yellobyte/YB-ESP32-S3-DAC/README.md

## YB-ESP32-S3-DAC Development Board Overview:
The **YB-ESP32-S3-DAC** is an audio development board based on Espressif's ESP32-S3 MCU with **Stereo Headphone** and **Stereo Speaker** output. It features an **ESP32-S3-WROOM-1** module (16MB Flash/8MB PSRAM or 8MB Flash/2MB PSRAM, WiFi PCB antenna) and is available on sales platforms [eBay](https://www.ebay.de/sch/i.html?_nkw=yb-esp32-s3) and [Ricardo.ch](https://www.ricardo.ch/en/s/YB-ESP32-S3). 

The 4-layer board is packed with features. It provides a **Texas Instruments TLV320 Stereo Audio DAC** with audio processing capability and integrated **Stereo Class-D Speaker Amplifier**, **3.5mm stereo audio jack**, **microSD** card slot, **CH334 USB-Hub** chip, **CH343 USB-UART bridge** chip, **USB-C connector** for software upload, serial output, JTAG debugging and/or feeding power to the board, **two status LEDs** and lots of **GPIO pins** for free use.

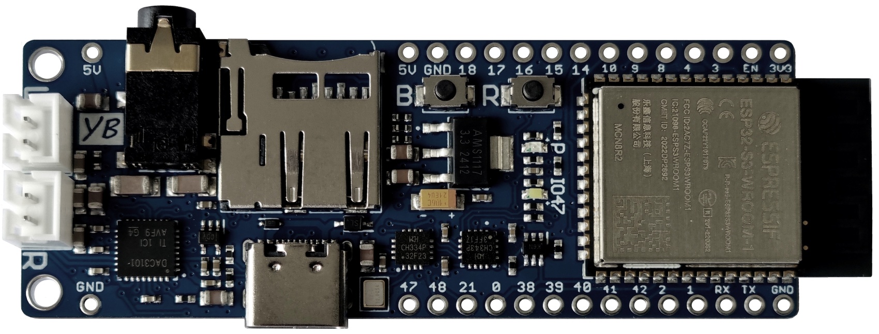
[picture p1: doc/YB-ESP32-S3-DAC_top.jpg]


Since the TLV320DAC3101 chip features sophisticated **audio processing capabilities** you can implement various types of audio filters, enable dynamic range compression (DRC), generate a 3D effect or use the integrated beep generator. The Arduino library [TLV320DAC3101](https://github.com/yellobyte/TLV320DAC3101) provides everything needed and lots of examples.

Due to the many available GPIOs you can connect additional hardware to the board, e.g. TFT displays, rotary encoders, IR receivers, modules that communicates via I2C/SPI and much more. The **I2S bus signals** (**D**ata, **L**eft/**R**ight (word) clock, **B**it clock) are accessible via **solder pads** on the bottom of the board for attaching external I2S components if needed.

The onboard USB-Hub (USB high-speed HUB controller chip CH334) allows for simultaneous **JTAG debugging** and **serial output**. More info further down.

The board is highly [**breadboard compatible**](https://github.com/yellobyte/YB-ESP32-S3-DAC/raw/main/doc/YB-ESP32-S3-DAC_on_breadboard.jpg) for it leaves one row of accessible breadboard contacts on either side of the board. All I/O ports (GPIOx) are clearly labeled on both sides of the board.

## Quickstart guide:
**All YB-ESP32-S3-DAC boards delivered have already been flashed with software example 'Play-All-MP3-Files-on-SD'.**

- Step 1) connect one or two 8Ω loudspeaker(s) or a headphone to the board
- Step 2) insert a microSD card (FAT32) holding some *.mp3 files
- Step 3) apply power (via USB or 5V pins)

That's it. The status LED will light up when the microSD card has been detected ok and the board will start playing all *.mp3 files found.

Carrying on you could build and upload one of the many provided ArduinoIDE/PlatformIO [examples](https://github.com/yellobyte/YB-ESP32-S3-DAC/tree/main/examples) and listen to **internet radio stations**, try out the **3D sound effect**, apply **low/high pass audio filters** and much more.

## YB-ESP32-S3-DAC board features in detail:
- **ESP32-S3-WROOM-1** module with 16MB Flash/2MB PSRAM (-N16R8) or 8MB Flash/2MB PSRAM (-N8R2), WiFi PCB antenna
- **TLV320DAC3101 Stereo Audio DAC** with audio processing capability (audio filters of 1st and 2nd order, dynamic range compression DRC, 3D effect), Stereo Class-D Speaker Amplifier (2 x 1.3W@8Ω) and Stereo Headphone output (2 x 65mW@16Ω impedance min.). The DAC is connected to the ESP32-S3 as follows:
  - Via I2C for DAC configuration & programming (I2C address 0x18):
    - *GPIO8 - SDA* (data line)
    - *GPIO9 - SCL* (clock line)
  - Via I2S for transferring audio data from ESP32-S3 to DAC:
    - *GPIO4 - MCLK* (master clock, optional when solder bridge is closed)
    - *GPIO5 - BCLK* (bit clock)
    - *GPIO6 - LRCLK/WCLK* (frame/word clock)
    - *GPIO7 - DIN* (digital audio signal)

  Note: GPIOs 5/6/7 are not wired to a board pin, however they are available via labeled solder pins on the bottom of the board.
 - **JST PH2.0 connectors** for easy connecting 2 loudspeakers (8Ω impedance, left & right audio channels)
 - **3.5mm stereo audio jack** acting as stereo headphone/headset output (16Ω min., microphone input, button press detection) or stereo line output (10kΩ nom.).
 - **microSD** card slot connected to the ESP32-S3 via fast SPI bus *FSPI*:
   - *GPIO10 - SCS* (SPI bus control, chip select, this control line is not needed for SD_MMC-lib and available for other usage when solder bridge *SD_CS* is open [default closed])
   - *GPIO11 - MOSI* (SPI bus data communication, SD_MMC calls it *CMD*)
   - *GPIO12 - SCK* (SPI bus clock signal)
   - *GPIO13 - MISO* (SPI bus data communication, SD_MMC calls it *D0*)

   Note: GPIOs 11/12/13 are not wired to any board pin, they are exclusively used for the microSD slot.
 - **control LEDs**. One LED labeled 'P' is connected to the 3.3V rail to indicate board power and the other LED labeled 'IO47' is connected to GPIO47 which can be used as status LED.
 - **USB-C** port connected to the onboard CH334 USB-Hub chip. This allows for serial output and simultaneous JTAG debugging as well as software upload (e.g. via ArduinoIDE, VSCode/PlatformIO etc). The ESP32-S3 contains an inbuild JTAG adapter hence [**debugging**](https://github.com/yellobyte/ESP32-DevBoards-Getting-Started/tree/main/debugging) becomes fairly easy.
 - **hardware logic** for *automatic* software upload (supported by most Development IDEs) via USB-C port using the onboard CH343 USB-UART bridge chip. How this works is explained [here](https://github.com/yellobyte/ESP32-DevBoards-Getting-Started/tree/main/reset_and_software_upload).
 - **pushbuttons**. One is labeled 'R' and resets the ESP32-S3 (shorts EN pin to ground) and the other one is labeled 'B' and shorts GPIO0 to ground when pressed. The combination is used to force the board into boot mode.
 - **lots of available GPIOs** for connecting LEDs, buttons, additional modules via second SPI bus or I2C, e.g displays, rotary encoders, bluetooth, etc.

## Board Pin Layout:
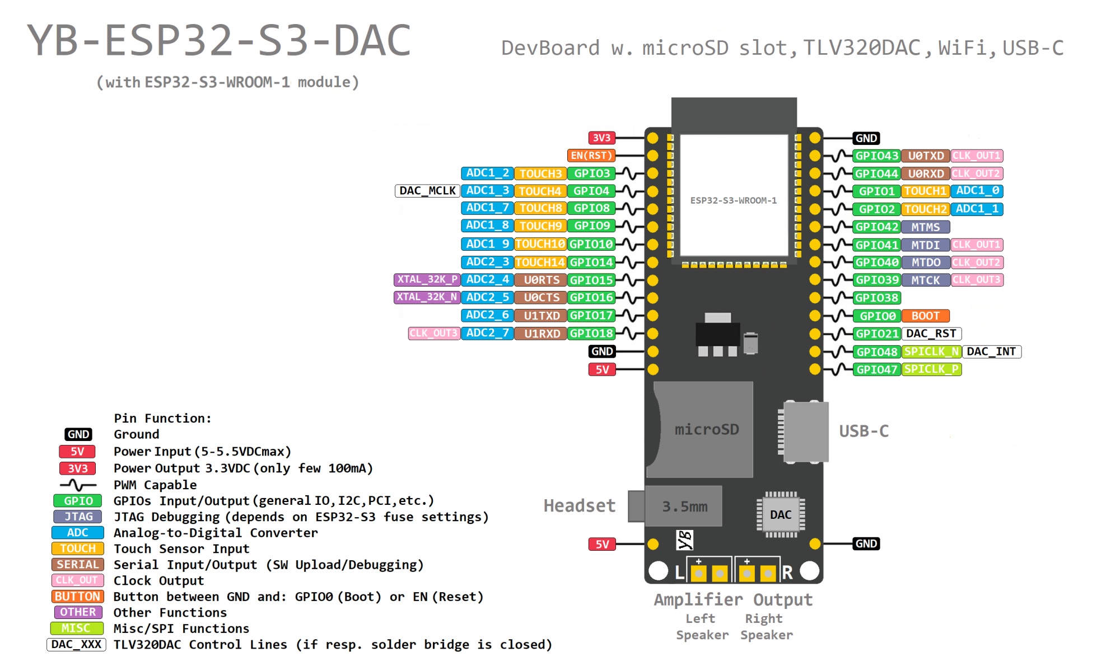
[picture p2: doc/YB-ESP32-S3-DAC_pinlayout.jpg]
 

The boards **outline** and **schematic** files are all located in folder [doc](https://github.com/yellobyte/YB-ESP32-S3-DAC/raw/main/doc), together with data sheets for Espressif's MCU ESP32-S3 and the ESP32-S3-WROOM-1 module family.

## Powering the board:
There are two ways to provide power to the board:
  - through the USB-C port or
  - ~5VDC applied to the 5V pin

The board uses LDOs to drop the external supply voltage down to 3.3V/1.8V needed by the board circuitry. The TLV320 speaker drivers get their voltage directly from pin '5V'. They can operate up to 5.5V and their absolute maximum rating is 6V. Therefore **never supply more than ~5.5VDC to the '5V' power input pins** !

Normal operating current of the idle board (all GPIOs unconnected, no audio output, WiFi disabled) is about 45mA. With WiFi active the board draws about 100mA (mainly depending on WiFi link). With WiFi active, a microSD in the slot and lower audio output power on both amp channels the current rises to ~160mA.

### Recommended wiring for max. audio output power:
Each speaker channel produces max. 1.3W output power at 8Ω. If your project requires more then just a few ~100mW of audio output power it is recommended to use a capable power supply (5VDC/1A). An additional capacitor of ~100uF or greater value across the 5V/GND pins of the board wouldn't hurt either.

## Application hints:
The board uses a WCH chip CH343P (USB-UART bridge). If you haven't done yet then you need to install the CH343 Driver on your Laptop/PC. For Windows go [here](https://www.wch-ic.com/search?t=all&q=ch343) and download and install the newest version of the driver. Linux provides CH34x drivers by default.

### Arduino IDE:
As of Arduino ESP32 Core V3.3.6 you open the board list, enter "yb" and select "**Yellobyte YB-ESP32-S3-DAC**". Then choose the proper settings for COM port, debug level, etc. as shown below. Be aware, since the ESP32-S3 MCU is very versatile there are a lot of build options to play with. Espressif's homepage offers some help.

Correct **settings** for boards with 16MB Flash & 8MB PSRAM (**-N16R8**):
- Board: *YB-ESP32-S3-DAC*
- USB CDC On Boot: _Disabled_
- Flash Size: *16MB (128Mb)*
- Partition Scheme: e.g. *16MB with spiffs (...)*, *8MB with spiffs (...)*, *Default 4MB with spiffs (...)*, etc.
- PSRAM: *OPI PSRAM*

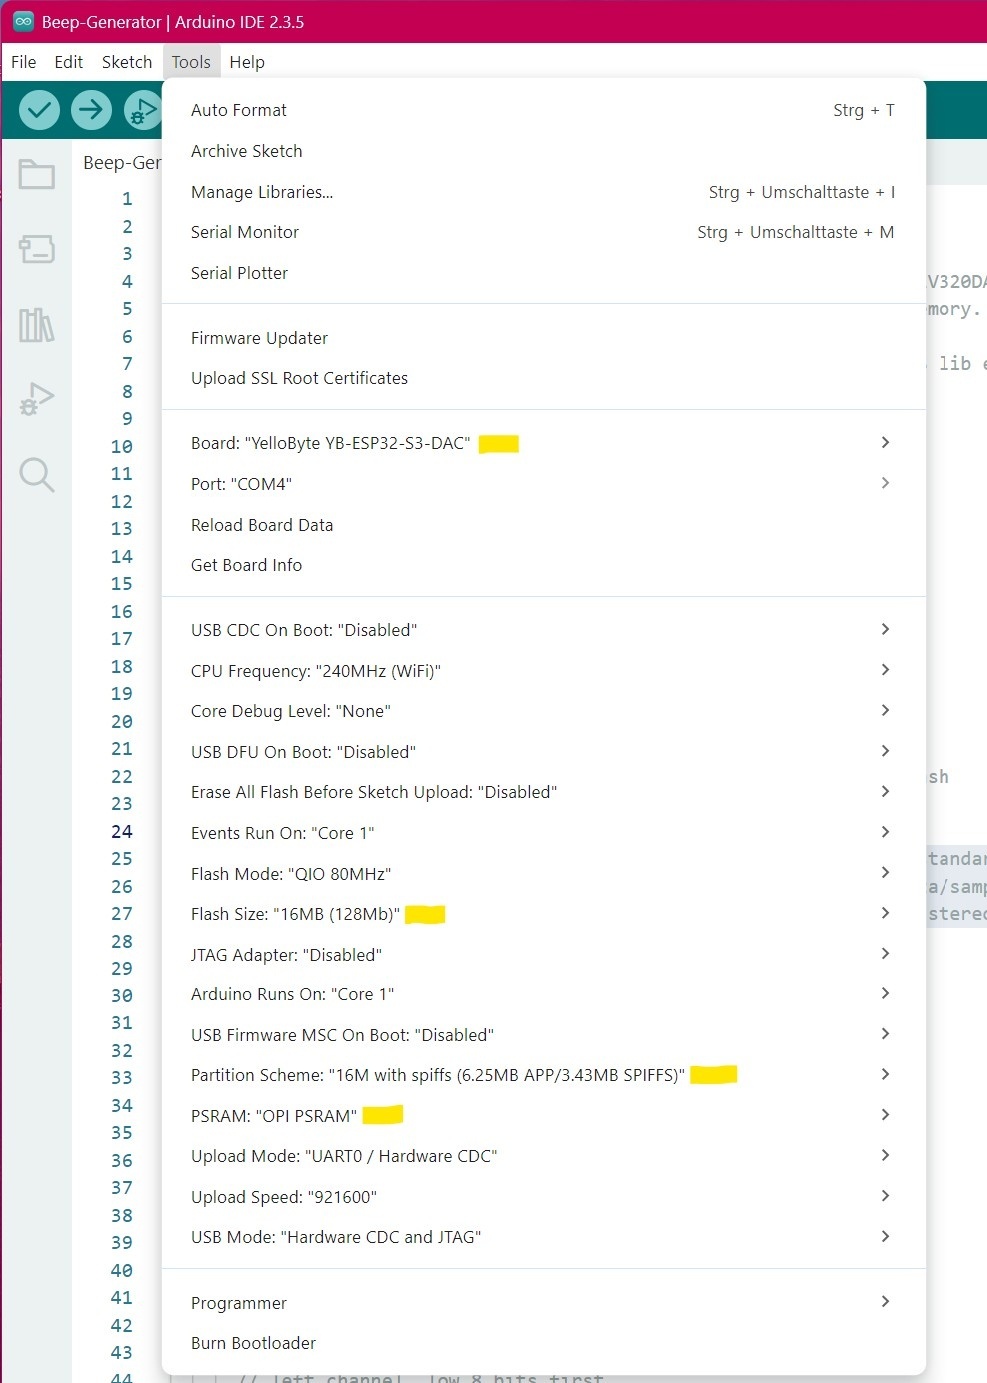
[picture p3: doc/YB-ESP32-S3-DAC_ArduinoIDE-Settings-N16R8.jpg]
 

Correct **settings** for boards with 8MB Flash & 2MB PSRAM (**-N8R2**):
- Board: *YB-ESP32-S3-DAC*
- USB CDC On Boot: _Disabled_
- Flash Size: *8MB (64Mb)*
- Partition Scheme: e.g. *8MB with spiffs (...)*, *Default 4MB with spiffs (...)*, etc.
- PSRAM: *QSPI PSRAM*

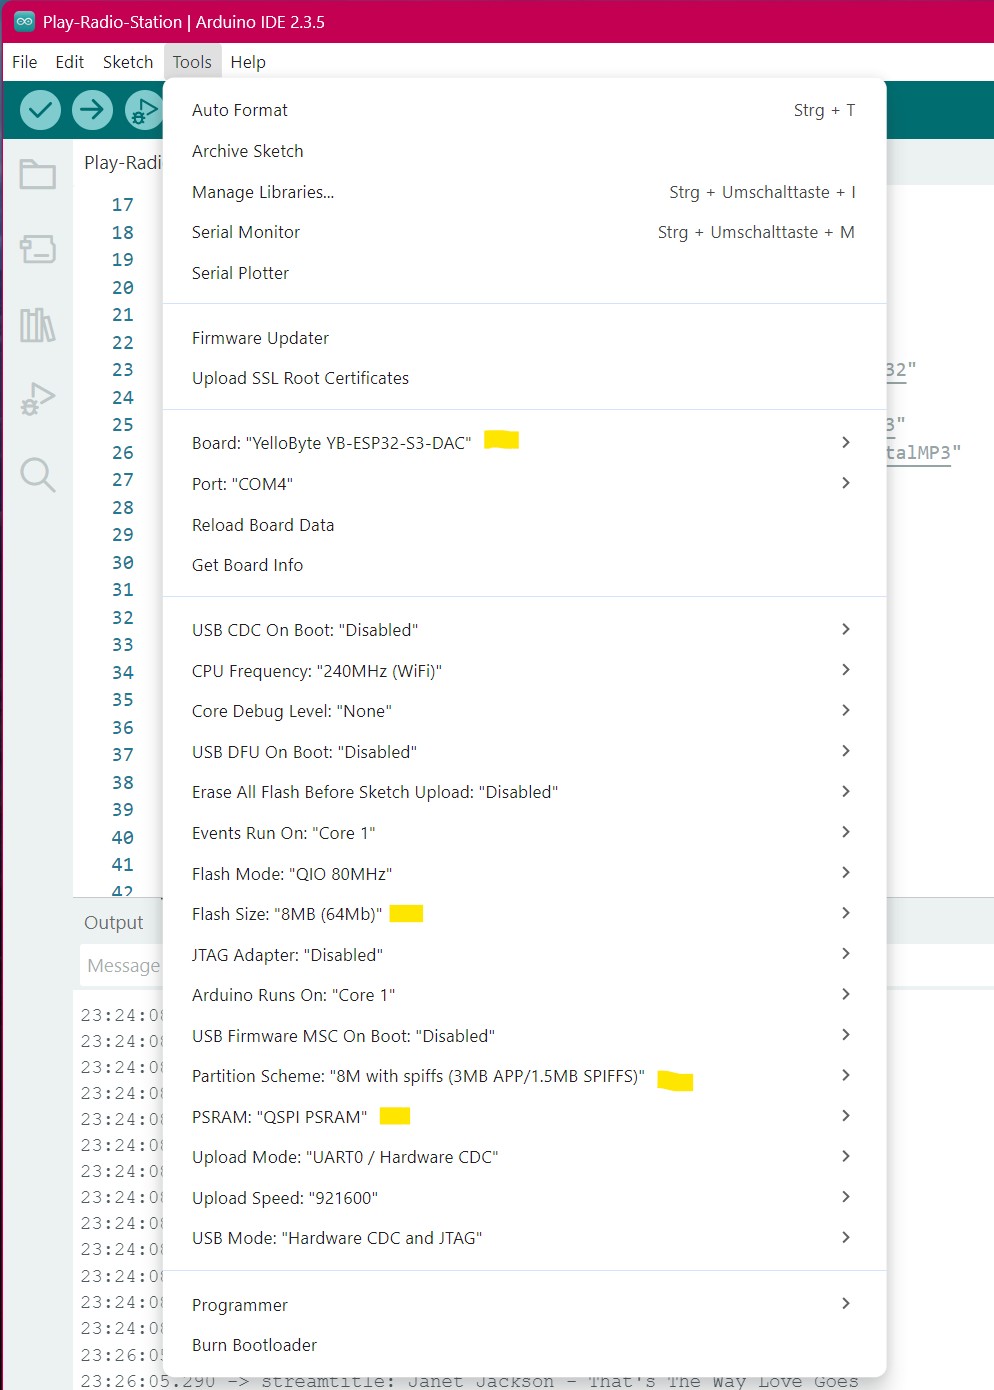
[picture p4: doc/YB-ESP32-S3-DAC_ArduinoIDE-Settings-N8R2.jpg]
 

### PlatformIO:
Building with **PlatformIO** is easy as well. Starting with Arduino ESP32 Core v3.3.6 the VSCode/PlatformIO IDE holds the necessary *.json board file which provides default board definitions & settings.

Just create a new project and give it a name, then go to board selection, enter "yb-" and choose your YB-ESP32-S3-*** board from the list that is popping up.

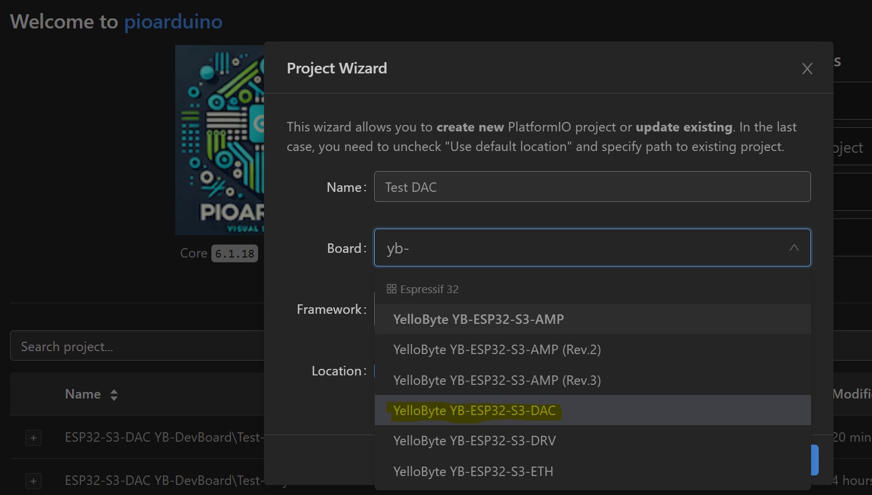
[picture p5: doc/YB-ESP32-S3-DAC_PlatformIO_board_selection.jpg]
 

**Important:**  
1.) If the WROOM module features **16MB** flash memory, add the following lines to the *platformio.ini* project file's respective **[env]** section to account for the 16MB flash available. Otherwise you are restricted to 8MB (as set in the *.json board file).  
```
...
board_build.partitions = default_16MB.csv
board_upload.flash_size = 16MB
board_upload.maximum_size = 16777216
...
```
2.) If the WROOM module features **>= 8MB** PSRAM then it needs below line to prevent the core from crashing:
```
...
board_build.arduino.memory_type = qio_opi
...
```

### Using the USB-C port:
With the board connected to your PC/Laptop you'll see 3 additional USB devices. Two COM ports: **Serial USB device** and **USB-Enhanced-Serial CH343** and one device: **USB JTAG/serial debug unit** (or similar, depending on your OS).

You can connect a serial monitor program on your PC/Laptop to device "USB-Enhanced-Serial CH343" and watch the serial output generated with e.g. Serial.print(). Important: This serial connection is **not** affected by any board reset.

Device "USB JTAG/serial debug unit" lets you simultaneously debug the board via the ESP32-S3 integrated JTAG debug circuitry. How to use the latter for debugging is explained in detail [**here**](https://github.com/yellobyte/ESP32-DevBoards-Getting-Started/tree/main/debugging).

**Please note:** The PlatformIO builder scripts (*.json) for modules containing ESP32-S3/C3 normally define the build flag _ARDUINO_USB_MODE=1_. This enables the USB-Serial-JTAG controller and disables the USB-OTG-Controller in the ESP32-S3. If you want to override it you can (re-)define it in your platformio.ini control file. Normally you don't have to worry about it.

### Software Upload to the board:
Uploading new software to boards with your IDE is a breeze. Select the correct COM port and upload the program. The [integrated hardware logic](https://github.com/yellobyte/ESP32-DevBoards-Getting-Started/tree/main/reset_and_software_upload) will put the board into upload mode automatically.

However, at any time and if needed you can force the ESP32-S3 into upload mode *manually*. Keep the **'B'** button pressed, then press/release the **'R'** button and finally release the **'B'** button. The serial monitor output will subsequently confirm the boards readiness for getting flashed.

```
....
23:19:07.453 > ESP-ROM:esp32s3-20210327
23:19:07.453 > Build:Mar 27 2021
23:19:07.453 > rst:0x1 (POWERON),boot:0x0 (DOWNLOAD(USB/UART0))
23:19:07.459 > waiting for download
```

### Flash/RAM usage:
The -N8R2 module on the board provides enough memory even for demanding projects. Building e.g. software example [Play-All-MP3-Files-on-SD](https://github.com/yellobyte/YB-ESP32-S3-DAC/tree/main/examples/ArduinoIDE/Play-All-MP3-Files-on-SD) shows the following Flash/RAM usage:
```
Executing task: C:\Users\tj\.platformio\penv\Scripts\platformio.exe run

Processing release (platform: https://github.com/pioarduino/platform-espressif32/releases/download/stable/platform-espressif32.zip; framework: arduino; board: yb_esp32s3_dac)
------------------------------------------------------------------------------------------------------------------------
Verbose mode can be enabled via `-v, --verbose` option
CONFIGURATION: https://docs.platformio.org/page/boards/espressif32/yb_esp32s3_dac.html
PLATFORM: Espressif 32 (55.3.37) > YelloByte YB-ESP32-S3-DAC
HARDWARE: ESP32S3 240MHz, 320KB RAM, 8MB Flash
DEBUG: Current (esp-builtin) On-board (esp-builtin) External (cmsis-dap, esp-bridge, esp-prog, iot-bus-jtag, jlink, minimodule, olimex-arm-usb-ocd, olimex-arm-usb-ocd-h, olimex-arm-usb-tiny-h, olimex-jtag-tiny, tumpa)
PACKAGES:
 - contrib-piohome @ 3.4.4
 - framework-arduinoespressif32 @ 3.3.7
 - framework-arduinoespressif32-libs @ 5.5.0+sha.87912cd291
 - tool-esp-rom-elfs @ 2024.10.11
 - tool-esptoolpy @ 5.1.2
 - toolchain-xtensa-esp-elf @ 14.2.0+20251107
*** Applied include path shortening for 336 framework paths ***
*** Path length reduced from 38684 to ~13910 characters ***
*** Estimated savings: 24192 characters ***
LDF: Library Dependency Finder -> https://bit.ly/configure-pio-ldf
LDF Modes: Finder ~ chain, Compatibility ~ soft
Found 47 compatible libraries
Scanning dependencies...
Dependency Graph
|-- SD @ 3.3.7
|-- Adafruit BusIO @ 1.17.4
|-- Adafruit TLV320 I2S @ 1.0.0
|-- TLV320DAC3101 @ 1.1.0
|-- ESP32-audioI2S @ 3.4.4
|-- FS @ 3.3.7
|-- SPI @ 3.3.7
Building in release mode
Retrieving maximum program size .pio\build\release\firmware.elf
Checking size .pio\build\release\firmware.elf
Advanced Memory Usage is available via "PlatformIO Home > Project Inspect"
RAM:   [==        ]  18.1% (used 59376 bytes from 327680 bytes)
Flash: [======    ]  58.7% (used 1963226 bytes from 3342336 bytes)
```

## Integrating this board into your own PCB design projects:
Its easy. Folder [doc](https://github.com/yellobyte/YB-ESP32-S3-DAC/tree/main/doc) provides the Eagle library file **_yb-esp32-S3-DAC.lbr_** containing the board. Most other PCB design software (e.g. KiCad) are able to import and use Eagle lib files.

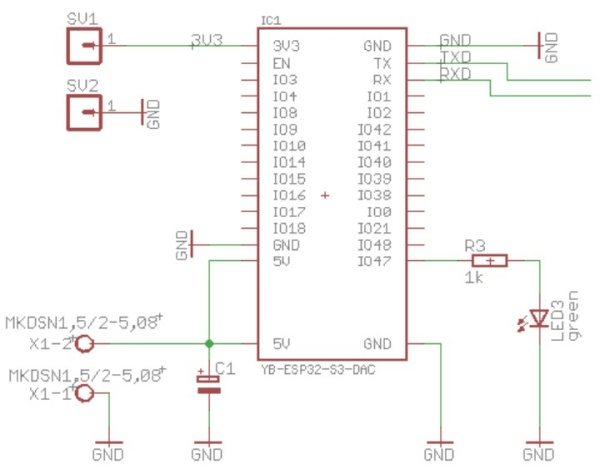
[picture p6: doc/Eagle_project_with_yb-esp32-s3-dac.jpg]
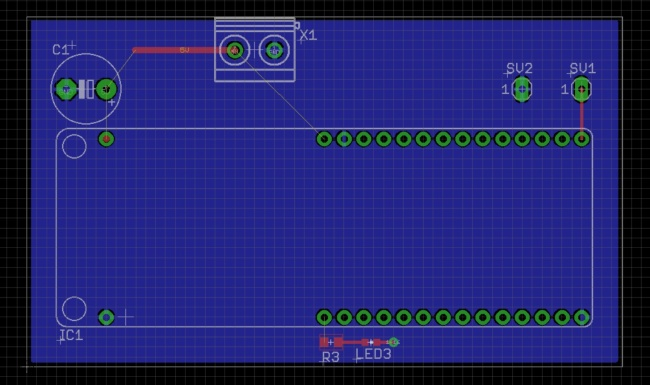
[picture p7: doc/Eagle_project_with_yb-esp32-s3-dac2.jpg]
<p align="center">&nbsp;</p>

## Running MicroPython on the board:

You can install MicroPython onto the YB-ESP32-S3-DAC board and use it's WiFi, SPI, I2C, ADC, GPIO and other features via python scripts.  
 
**Step 1)** Load MicroPython onto the board. Go to https://micropython.org/download/ESP32_GENERIC_S3/ and download the newest *.bin firmware release. Here you will find detailed installation instructions as well.

**Step 2)** Erase the entire flash on the board with 
```
esptool.py erase_flash
```
If esptool.py can't determine which port your board is connected to, try
```
esptool.py --port PORTNAME erase_flash
```
**Step 3)** Flash the previously downloaded firmware to the board, e.g.
```
esptool.py --port COM4 --baud 460800 write_flash 0 ESP32_GENERIC_S3-20260406-v1.28.0.bin
```
**Step 4)** Reboot the board by shortly pressing the 'R' button. Then connect your serial monitor to the correct port (here COM4) and press ENTER. If flashing was successful you will be greeted with
```
01:57:53.819 > Build:Mar 27 2021
01:57:53.819 > rst:0x1 (POWERON),boot:0x8 (SPI_FAST_FLASH_BOOT)
01:57:53.825 > SPIWP:0xee
01:57:53.825 > mode:DIO, clock div:1
01:57:53.825 > load:0x3fce2820,len:0xeac
01:57:53.830 > load:0x403c8700,len:0xc28
01:57:53.830 > load:0x403cb700,len:0x2ff8
01:57:53.830 > entry 0x403c88ac
01:57:54.370 > MicroPython v1.28.0 on 2026-04-06; Generic ESP32S3 module with ESP32S3
01:57:54.375 > Type "help()" for more information.
01:57:54.375 > >>> 
```
which confirms that MicroPython is now up and running on your board. Just enter *help()* and MicroPython will present some help info.

**Example: Switching the onboard status LED (GPIO47) on/off:**
```
>>> import machine <Enter>
>>> from machine import Pin <Enter>
>>> p0 = Pin(47, Pin.OUT) <Enter>
>>> p0.on() <Enter>
>>> p0.off() <Enter>
```

## General notes:
1) In case you get left channel output on the right speaker and vice-versa (L + R channels are swapped) you need to build with a [newer ESP32-AudioI2S library version](https://github.com/schreibfaul1/ESP32-audioI2S/releases) with this error fixed.

2) The ESP32-S3 includes four SPI controllers: SPI0, SPI1, SPI2(Fast SPI) and SPI3. SPI0/1 are reserved for Flash and PSRAM (if available) and should be left alone!
The remaining two are available for the public. In the ESP32-S3's Arduino universe SPI2 & SPI3 are named FSPI & HSPI. FSPI by default is assigned to GPIOs 10-15 and routed via IO MUX. However, both can get pinned to any available GPIO pin if needed but FSPI will be slower if routed through GPIO Matrix

3) The ESP32-S3-WROOM-1 module family comprises several [**versions**](https://github.com/yellobyte/ESP32-DevBoards-Getting-Started/raw/main/ESP32_specs_and_manuals/ESP32-S3-WROOM-1(U)_Variants.jpg). The **-1** versions come with embedded PCB antenna, the **-1U** versions with IPEX antenna socket instead. The extension -Nx(Ry) defines the amount of integrated FLASH/PSRAM, e.g. -N4 (4MB Flash, no PSRAM), -N4R2 (4 MB Flash, 2MB PSRAM), -N8R2 (8 MB Flash, 2MB PSRAM) etc.

4) The board supports USB Serial JTAG debugging via ESP32-S3 integrated JTAG circuitry. Look [**here**](https://github.com/yellobyte/ESP32-DevBoards-Getting-Started/tree/main/debugging).
