yellobyte/YB-ESP32-S3-DAC/examples/PlatformIO/PlayFilesOnSD-SdFatFS/Lautstärkeregelung_Empfehlungen_TLV320-Serie.md

Die TLV320-Serie von Texas Instruments (z. B. TLV320DAC310x, TLV320AIC3104, AIC3204) bietet eine
hohe Flexibilität und ermöglicht sowohl eine digitale als auch eine analoge Lautstärkeregelung. Die Wahl hängt von den Anforderungen an die Audioqualität und den Schaltungsaufbau ab. 
Hier ist eine Gegenüberstellung basierend auf den Datenblättern der TI TLV320-Reihe:
1. Digitale Lautstärkeregelung (Im Chip)

    Funktionsweise: Die Lautstärke wird direkt in den Registern des DACs gesteuert, bevor das Signal in das analoge Signal umgewandelt wird (DSP/Register-gesteuert).
    Vorteile:
        Perfekte Kanalgleichheit: Da es sich um eine mathematische Berechnung handelt, sind linker und rechter Kanal zu 100 % identisch.
        Kein mechanischer Verschleiß: Kein Knistern durch Abnutzung.
        Einfache Implementierung: Kann über I2C/SPI gesteuert werden.
    Nachteile:
        Reduzierung der effektiven Bit-Auflösung bei sehr niedrigen Lautstärken.
        Hinweis: Bei modernen 24-Bit-DACs wie der TLV320-Serie ist dies in der Praxis kaum hörbar. 

2. Analoge Lautstärkeregelung (Nach dem DAC)

    Funktionsweise: Der DAC gibt das Signal mit voller Auflösung aus, und ein analoger Verstärker/Potentiometer (intern im TLV320 oder extern) regelt die Amplitude.
    Vorteile:
        Besseres Signal-Rausch-Verhältnis (SNR): Bei geringer Lautstärke wird auch das Grundrauschen des DACs mit abgesenkt.
        Volle Dynamik: Die volle Bittiefe bleibt erhalten.
    Nachteile:
        Potenzielle Kanalungleichheit bei mechanischen Potentiometern.
        Mehr Schaltungsaufwand (externe Komponenten). 

Was ist bei TLV320 zu empfehlen?
Die TLV320-Chips (insb. Codecs wie TLV320AIC3104/AIC3204) verfügen über eine integrierte analoge Lautstärkeregelung nach der Wandlung (im Ausgangsmischer/Kopfhörerverstärker). 

    Empfehlung: Nutzen Sie die integrierte analoge Regelung der TLV320-Ausgangsstufen. Sie bietet die Vorteile einer analogen Regelung (kein Rauschen), ohne die Nachteile externer mechanischer Teile.
    Für eine "Best-of-both-worlds"-Lösung: Nutzen Sie die digitale Regelung für grobe Einstellungen und die analoge (im Chip) für die Feinabstimmung. 

Zusammenfassung der Eigenschaften
Feature 	        Digitale Regelung (Register)	Analoge Regelung (Ausgangs-Amp)
Kanalgleichheit	    Perfekt	                        Gut (wenn im Chip)
SNR	                Verringert sich bei leise	    Besser bei leise
Auflösung	        Bits gehen verloren	            Bleibt hoch
Verfügbar in        TLV320	Ja (in den Registern)	Ja (integrierte analoge Stufe)
Die meisten modernen Anwendungen mit TLV320-Komponenten (z.B. über I2C gesteuert) nutzen die integrierte Lautstärkeregelung, da sie sehr flexibel und rauscharm ist
