yellobyte/YB-ESP32-S3-DAC/doc/YB-ESP32-S3-DAC_ArduinoIDE_Board-Selection.jpg

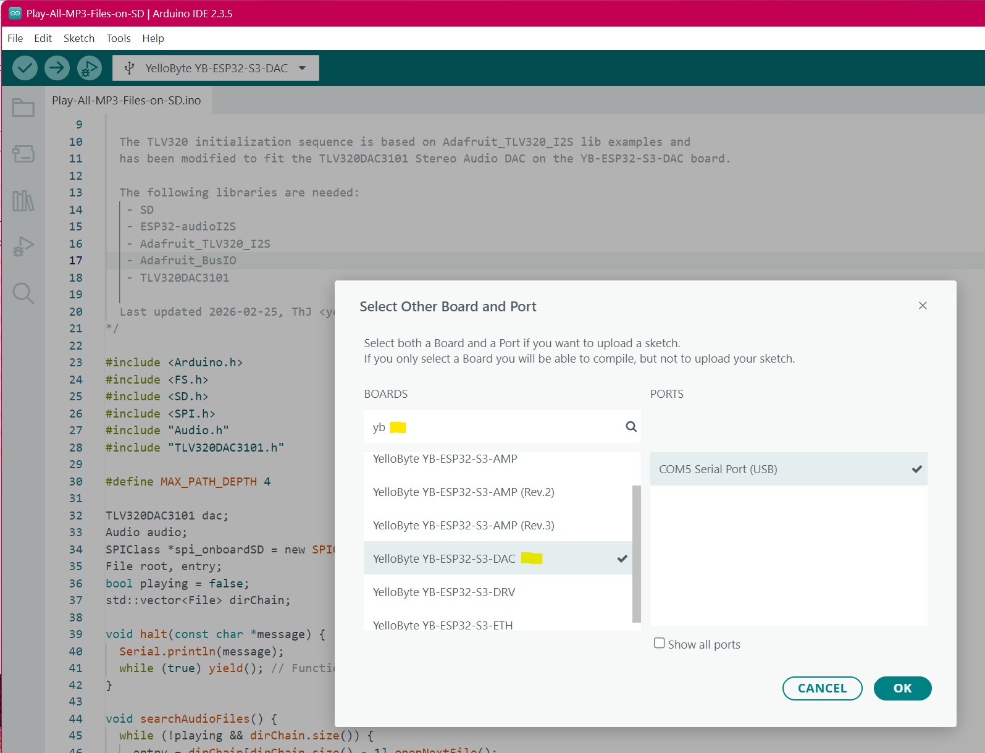
doc/YB-ESP32-S3-DAC_ArduinoIDE_Board-Selection.jpg
