yellobyte/YB-ESP32-S3-DAC/doc/YB-ESP32-S3-DAC_bottom.jpg

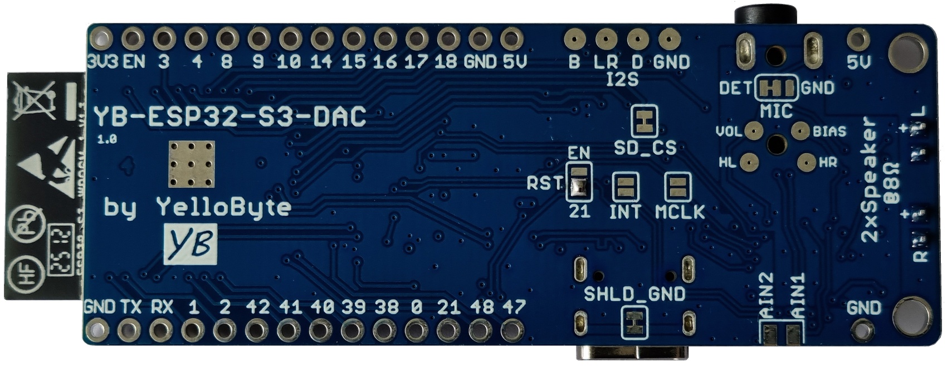
doc/YB-ESP32-S3-DAC_bottom.jpg
