yellobyte/YB-ESP32-S3-DAC/doc/YB-ESP32-S3-DAC_modules_replacement.jpg

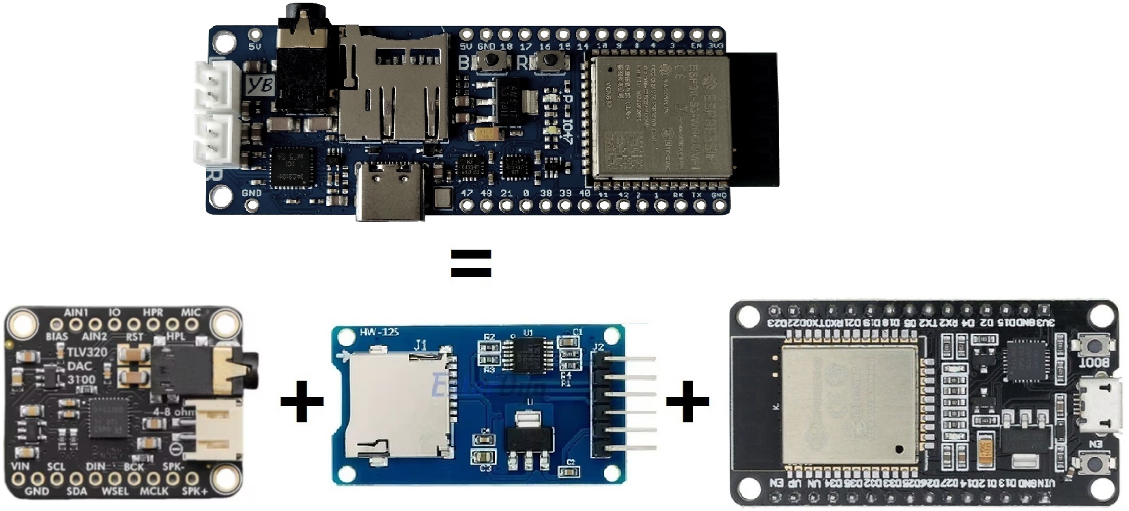
doc/YB-ESP32-S3-DAC_modules_replacement.jpg
