yellobyte/YB-ESP32-S3-DAC/doc/YB-ESP32-S3-DAC_on_breadboard.jpg

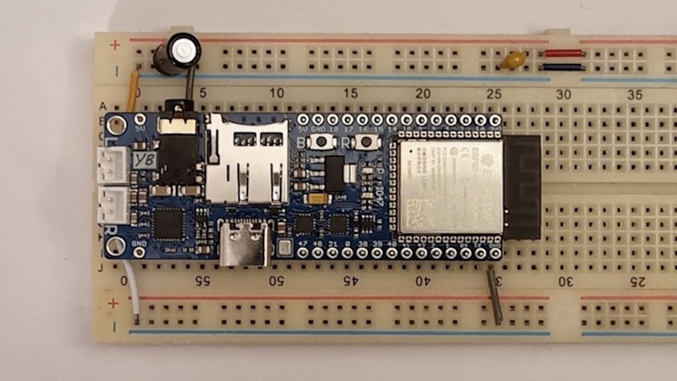
doc/YB-ESP32-S3-DAC_on_breadboard.jpg
