yellobyte/YB-ESP32-S3-DAC/doc/YB-ESP32-S3-DAC_outline.jpg

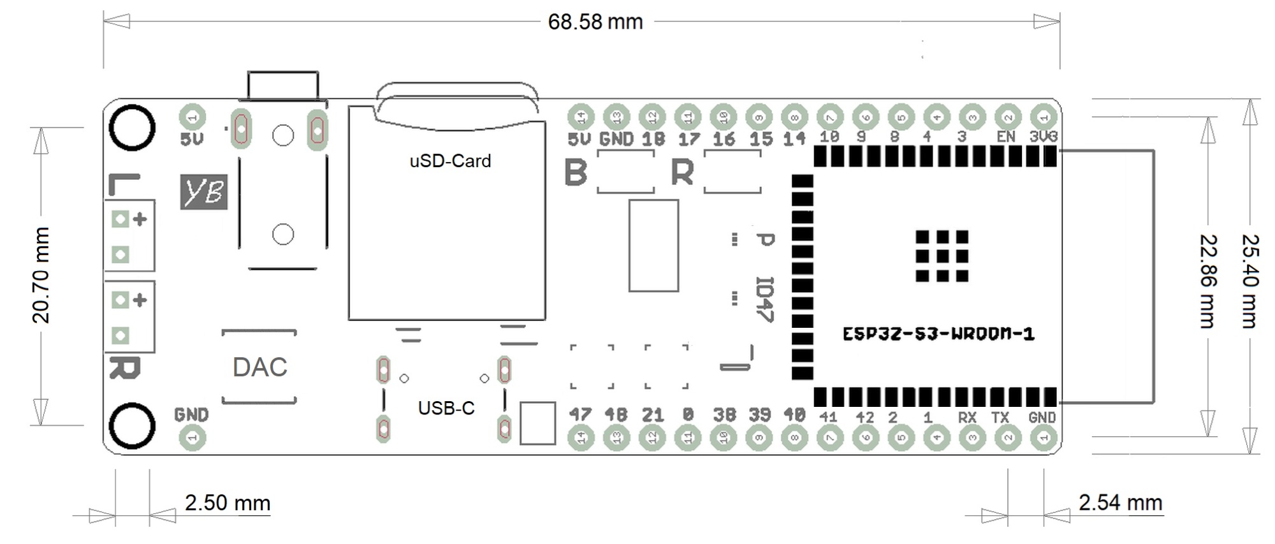
doc/YB-ESP32-S3-DAC_outline.jpg
