yellobyte/YB-ESP32-S3-DAC/doc/YB-ESP32-S3-DAC_schematic_2-2.jpg

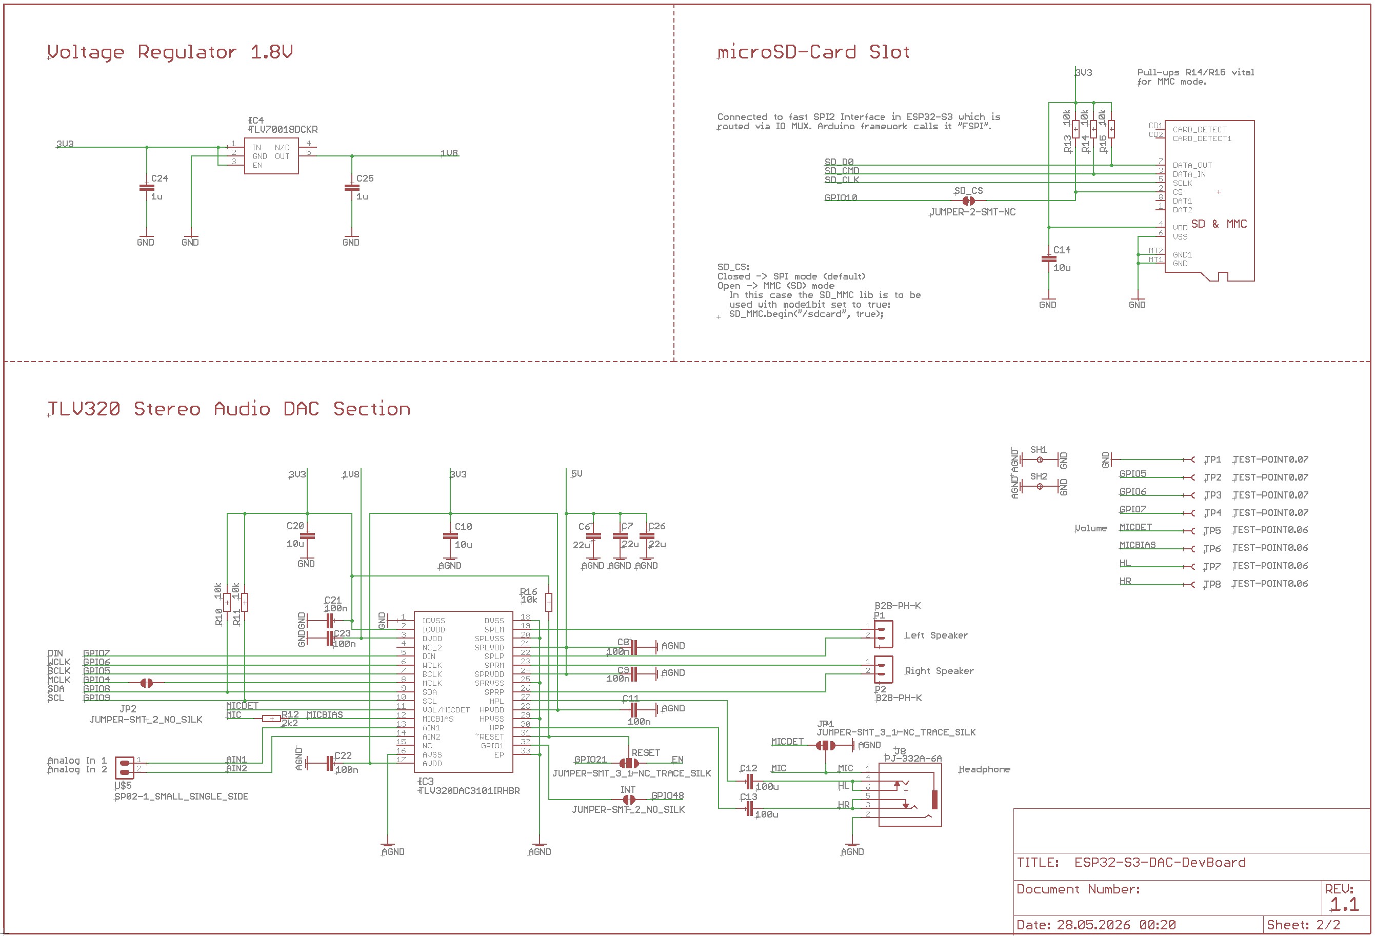
doc/YB-ESP32-S3-DAC_schematic_2-2.jpg
