yellobyte/YB-ESP32-S3-DAC/doc/YB-ESP32-S3-DAC_recommended_wiring.jpg

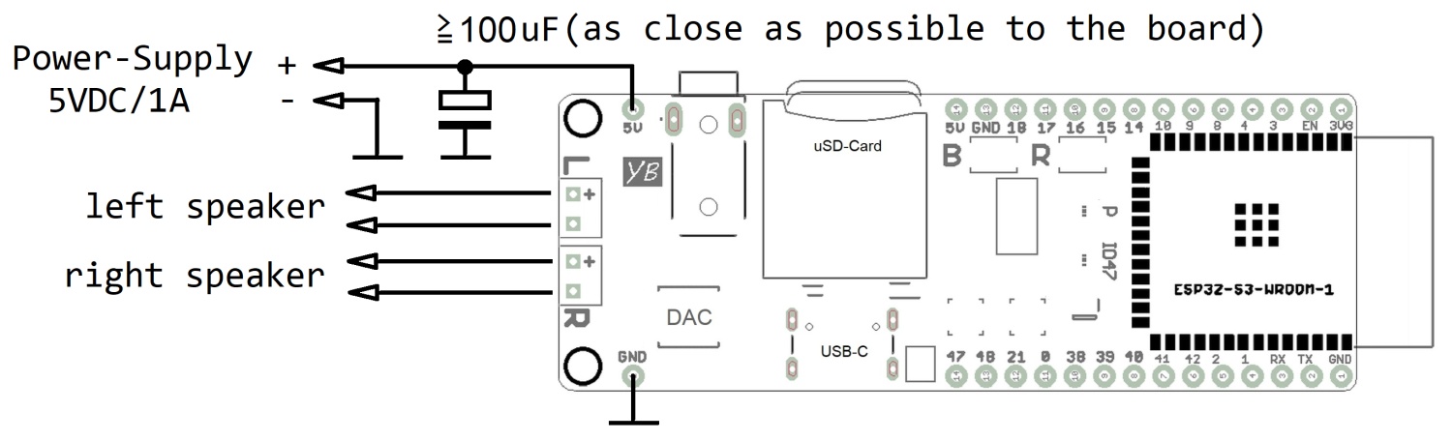
doc/YB-ESP32-S3-DAC_recommended_wiring.jpg
